maksog123/Line-follower/3D_projekty/wheel_connector.3mf

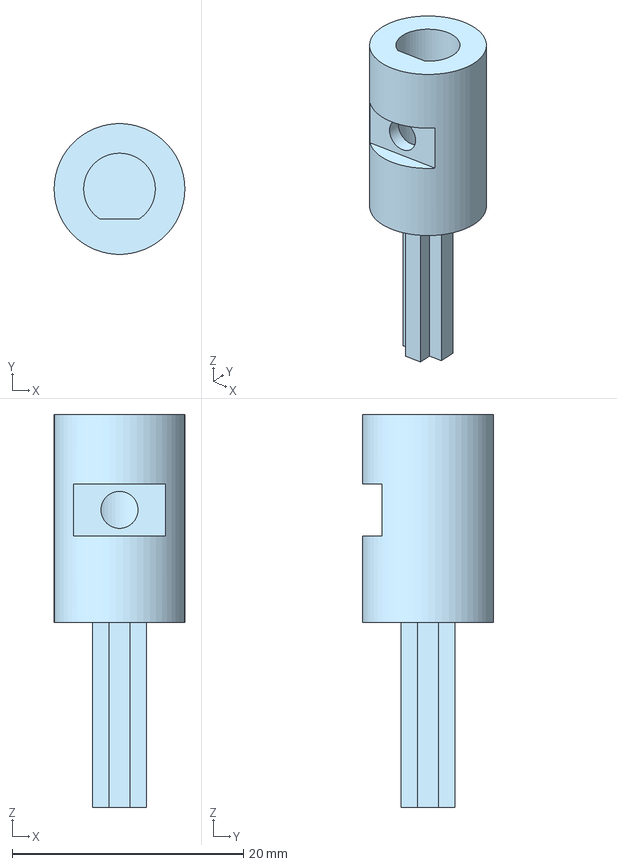
[picture p5: CAD file, 2025-09-29]
3D_projekty/wheel_connector.3mf
11.3 x 11.3 x 34.0 mm
