maksog123/Line-follower/3D_projekty/Line_follower_podstawa.3mf

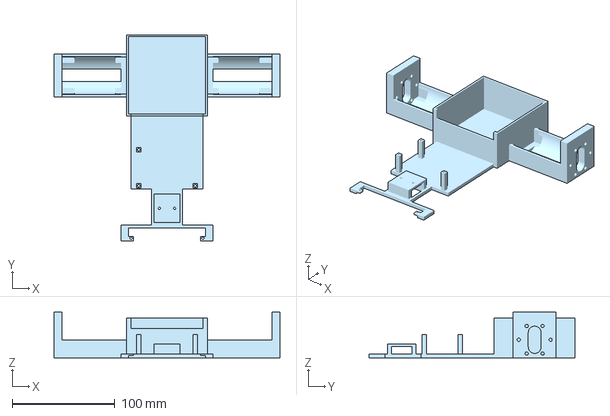
[picture p6: CAD file, 2025-09-29]
3D_projekty/Line_follower_podstawa.3mf
220.0 x 201.0 x 44.3 mm
