maksog123/Line-follower/Core/Src/main.c

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
/* Includes ------------------------------------------------------------------*/
#include "main.h"

/* USER CODE BEGIN PTD */
#define N_SENSORS 8
#define SENSOR_MAX 10
#define SENSOR_MIN 0


#define TIME_THRESHOLD SENSOR_MAX + 5
/* USER CODE END PTD */

TIM_HandleTypeDef htim10;
TIM_HandleTypeDef htim11;

void SystemClock_Config(void);
static void MX_GPIO_Init(void);
static void MX_TIM10_Init(void);
static void MX_TIM11_Init(void);
/* USER CODE BEGIN 0 */
GPIO_InitTypeDef Input = {0};
GPIO_InitTypeDef Output = {0};



int16_t abs(int16_t x) {
	return x < 0 ? -x : x;
}

void setMotorSpeed(int16_t l, int16_t r) {
	if (l > 0) {
		HAL_GPIO_WritePin(DIRA_2_GPIO_Port, DIRA_2_Pin, GPIO_PIN_SET);
		HAL_GPIO_WritePin(DIRB_2_GPIO_Port, DIRB_2_Pin, GPIO_PIN_RESET);
	} else if (l < 0) {
		HAL_GPIO_WritePin(DIRA_2_GPIO_Port, DIRA_2_Pin, GPIO_PIN_RESET);
		HAL_GPIO_WritePin(DIRB_2_GPIO_Port, DIRB_2_Pin, GPIO_PIN_SET);
	} else {
		HAL_GPIO_WritePin(DIRA_2_GPIO_Port, DIRA_2_Pin, GPIO_PIN_SET);
		HAL_GPIO_WritePin(DIRB_2_GPIO_Port, DIRB_2_Pin, GPIO_PIN_SET);
	}
	__HAL_TIM_SET_COMPARE(&htim11, TIM_CHANNEL_1, abs(l));

	if (r > 0) {
		HAL_GPIO_WritePin(DIRA_1_GPIO_Port, DIRA_1_Pin, GPIO_PIN_SET);
		HAL_GPIO_WritePin(DIRB_1_GPIO_Port, DIRB_1_Pin, GPIO_PIN_RESET);
	} else if (r < 0) {
		HAL_GPIO_WritePin(DIRA_1_GPIO_Port, DIRA_1_Pin, GPIO_PIN_RESET);
		HAL_GPIO_WritePin(DIRB_1_GPIO_Port, DIRB_1_Pin, GPIO_PIN_SET);
	} else {
		HAL_GPIO_WritePin(DIRA_1_GPIO_Port, DIRA_1_Pin, GPIO_PIN_SET);
		HAL_GPIO_WritePin(DIRB_1_GPIO_Port, DIRB_1_Pin, GPIO_PIN_SET);
	}
	__HAL_TIM_SET_COMPARE(&htim10, TIM_CHANNEL_1, abs(r));
}

int16_t* readSensor(uint32_t maxTick) {

}

GPIO_TypeDef* pinbanks[N_SENSORS] = {GPIOA, GPIOA, GPIOA, GPIOA, GPIOA, GPIOA, GPIOA, GPIOA};
uint16_t pins[N_SENSORS] = {GPIO_PIN_0, GPIO_PIN_1, GPIO_PIN_2, GPIO_PIN_3, GPIO_PIN_4, GPIO_PIN_5, GPIO_PIN_6, GPIO_PIN_7};
void measure_levels(uint32_t values[N_SENSORS]) {
    for (size_t i = 0; i < N_SENSORS; i++) {
        Output.Pin = pins[i];
        HAL_GPIO_Init(pinbanks[i], &Output);
        HAL_GPIO_WritePin(pinbanks[i], pins[i], GPIO_PIN_SET);
    }
    HAL_Delay(10); // I think this actually can be 1/1000 of that.
    for (size_t i = 0; i < N_SENSORS; i++) {
        Input.Pin = pins[i];
        HAL_GPIO_Init(pinbanks[i], &Input);
    }

    uint8_t any_high = N_SENSORS;
    uint8_t high_pins[N_SENSORS];
    for (size_t i = 0; i < N_SENSORS; i++) {
        high_pins[i] = 1;
    }
    uint32_t start = HAL_GetTick(); // Should we measure this in microseconds?

    while (any_high) {
        if (HAL_GetTick() - start > TIME_THRESHOLD) {
            break;
        }
        for (size_t i = 0; i < N_SENSORS; i++) {
            if (high_pins[i]) {
                if (HAL_GPIO_ReadPin(pinbanks[i], pins[i]) != GPIO_PIN_SET) {
                    any_high--;
                    high_pins[i] = 0;
                    values[i] = HAL_GetTick() - start;
                }
            }
        }
    }
    for (int i = 0;  i < N_SENSORS; i ++) {
    	if (high_pins[i]) {
    		values[i] = SENSOR_MAX;
    	}
    }
}

double get_target_score() {
    return 0.0; // Half of the sensors should look at white, half at black.
}

double get_score(uint32_t values[N_SENSORS]) {
	double sum = values[0] + values[1] + values[2] + values[3] + values[4] + values[5] + values[6] + values[7];
	return ((double)(values[0] * 7 + values[1] * 5 + values[2] * 3 + values[3] * 1 + values[4] * -1 + values[5] * -3 + values[6] * -5 + values[7] * -7)) / sum;
}

typedef enum Motor {
    LEFT,
    RIGHT
} Motor;

void set_motor_speed(uint8_t percentage, Motor motor) {

}

void init_pinconfig() {
    Input.Mode = GPIO_MODE_INPUT;
    Input.Pull = GPIO_NOPULL;

    Output.Mode = GPIO_MODE_OUTPUT_PP;
    Output.Pull = GPIO_NOPULL;
    Output.Speed = GPIO_SPEED_FREQ_LOW;
}

#define MIN_SPEED 10
#define MAX_SPEED 50

uint8_t cap_motor_speed(uint8_t percentage) {
    if (percentage < MIN_SPEED) {
        percentage = MIN_SPEED;
    }

    if (percentage > MAX_SPEED) {
        percentage = MAX_SPEED;
    }

    return percentage;
}

double kp = 2.0;
double ki = 0.1;
double kd = 0.1;

double integral = 0;
double previous_error = 0;
double last_time = 0;

int32_t pid_loop() {
    uint32_t values[N_SENSORS];
    measure_levels(values);
    double score = get_score(values);
    double error = get_target_score() - score;
    double now = HAL_GetTick();
    double dt = now - last_time;
    dt *= 0.001;
    last_time = now;

    double proportional = error;
    integral += error * dt;
    double derivative = (error - previous_error) / dt;
    double output = kp * proportional + ki * integral + kd * derivative;
    previous_error = error;

    return output;
}

int32_t last_left = 50;
int32_t last_right = 50;

void adjust_motors(double score) {
    last_left = cap_motor_speed(last_left + score);
    last_right = cap_motor_speed(last_right - score);
    setMotorSpeed(last_left * 10 - 1, last_right * 10 - 1);
}



/* USER CODE END 0 */

/**
  * @brief  The application entry point.
  * @retval int
  */
int main(void)
{

  /* USER CODE BEGIN 1 */
	 uint8_t MSG[35] = {'\0'};

	 init_pinconfig();


  /* USER CODE END 1 */

  /* MCU Configuration--------------------------------------------------------*/

  /* Reset of all peripherals, Initializes the Flash interface and the Systick. */
  HAL_Init();

  /* Configure the system clock */
  SystemClock_Config();

  /* Initialize all configured peripherals */
  MX_GPIO_Init();
  MX_TIM10_Init();
  MX_TIM11_Init();
  /* USER CODE BEGIN 2 */

  // Init motors
  HAL_TIM_PWM_Start(&htim10, TIM_CHANNEL_1);
  HAL_TIM_PWM_Start(&htim11, TIM_CHANNEL_1);

  // Init LEDs
  HAL_GPIO_WritePin(LED_ON_GPIO_Port, LED_ON_Pin, GPIO_PIN_SET);

  setMotorSpeed(0, 0);
  HAL_GPIO_WritePin(DIRA_1_GPIO_Port, DIRA_1_Pin, GPIO_PIN_SET);
  HAL_GPIO_WritePin(DIRB_1_GPIO_Port, DIRB_1_Pin, GPIO_PIN_RESET);
  HAL_GPIO_WritePin(DIRA_2_GPIO_Port, DIRA_2_Pin, GPIO_PIN_SET);
  HAL_GPIO_WritePin(DIRB_2_GPIO_Port, DIRB_2_Pin, GPIO_PIN_RESET);
  setMotorSpeed(500, 500);

  HAL_GPIO_WritePin(LED_ON_GPIO_Port, LED_ON_Pin, GPIO_PIN_SET);
  HAL_TIM_PWM_Start(&htim11, TIM_CHANNEL_1);

  last_time = HAL_GetTick();

  /* USER CODE END 2 */

  /* Infinite loop */
  /* USER CODE BEGIN WHILE */
  while (1) {
      double score = pid_loop();
      adjust_motors(score);
       //sprintf(MSG, "score = %d\r\n", score);
       //HAL_UART_Transmit(&huart1, MSG, sizeof(MSG), 100);
       HAL_Delay(2);
   }


//	HAL_GPIO_TogglePin(LED_GPIO_Port, LED_Pin);
//	HAL_GPIO_TogglePin(DIRA_1_GPIO_Port, DIRA_1_Pin);
//	HAL_GPIO_TogglePin(DIRB_1_GPIO_Port, DIRB_1_Pin);
//  HAL_GPIO_TogglePin(DIRA_2_GPIO_Port, DIRA_2_Pin);
//	HAL_GPIO_TogglePin(DIRB_2_GPIO_Port, DIRB_2_Pin);
//	HAL_Delay(1000);
    /* USER CODE END WHILE */

}

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
