maksog123/Line-follower/Core/Inc/main.h

#define LED_Pin GPIO_PIN_13
#define LED_GPIO_Port GPIOC
#define LED_ON_Pin GPIO_PIN_0
#define LED_ON_GPIO_Port GPIOB
#define DIRB_2_Pin GPIO_PIN_13
#define DIRB_2_GPIO_Port GPIOB
#define DIRA_2_Pin GPIO_PIN_14
#define DIRA_2_GPIO_Port GPIOB
#define DIRB_1_Pin GPIO_PIN_15
#define DIRB_1_GPIO_Port GPIOB
#define DIRA_1_Pin GPIO_PIN_8
#define DIRA_1_GPIO_Port GPIOA
#define SPEED_2_Pin GPIO_PIN_8
#define SPEED_2_GPIO_Port GPIOB
#define SPEED_1_Pin GPIO_PIN_9
#define SPEED_1_GPIO_Port GPIOB
